ilyas9461/door-control-automation/foto/pcb3d.png

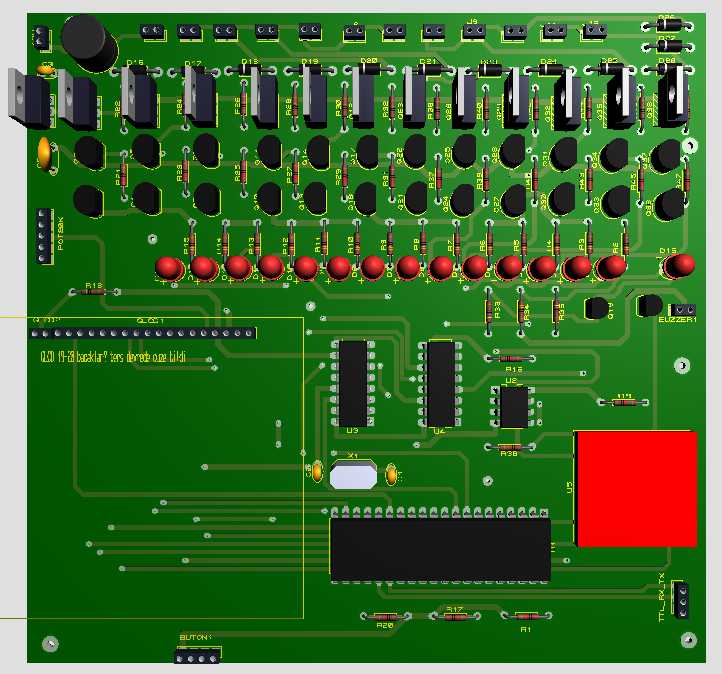
foto/pcb3d.png
