ilyas9461/door-control-automation/foto/Id-12 baglanti.JPG

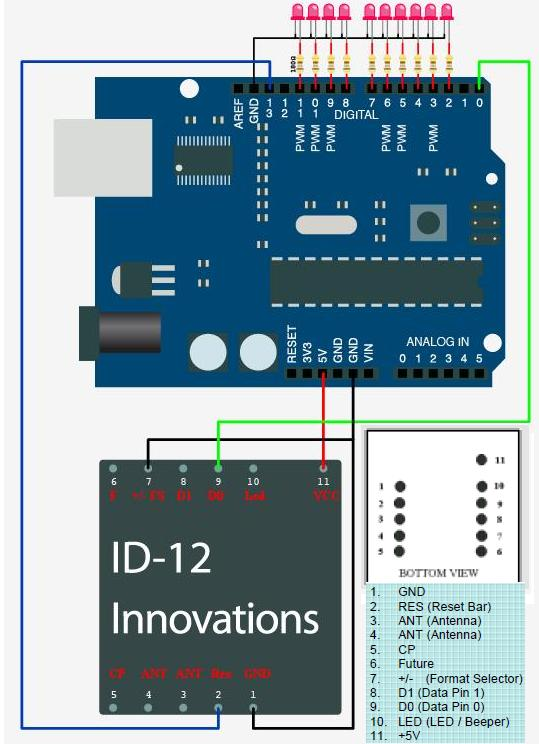
foto/Id-12 baglanti.JPG
