ilyas9461/door-control-automation/README.md

## **CONTACTLESS CARD DOOR CONTROL AUTOMATION PROJECT**

### Purpose of the Project :

Ensuring access control to work environments and preventing unnecessary entries by controlling the doors of work areas in any common area (corridor, etc.) from a central point with the contactless card (RFID Tag) given to each user.
Ensuring that entries and exits are made only with the permission of defined users.

[Click for sample working video...](https://youtu.be/mgzPTarc4ds)

### **The subject of the project** :

- RFID (Radio Frequency İdentification).
- MCU (PIC18F452)
- RFID.
- Door mechanical systems. 
- MOSFET drvers.
- Graphic LCD’s (GLCD).
- Microcontroller software languages and programming.
- PCB design.
