ilyas9461/door-control-automation/foto/calisma1.png

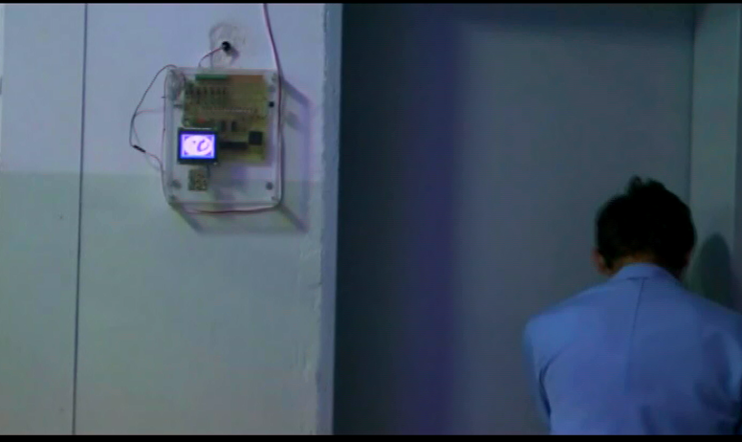
foto/calisma1.png
