ilyas9461/door-control-automation/foto/calisma2.png

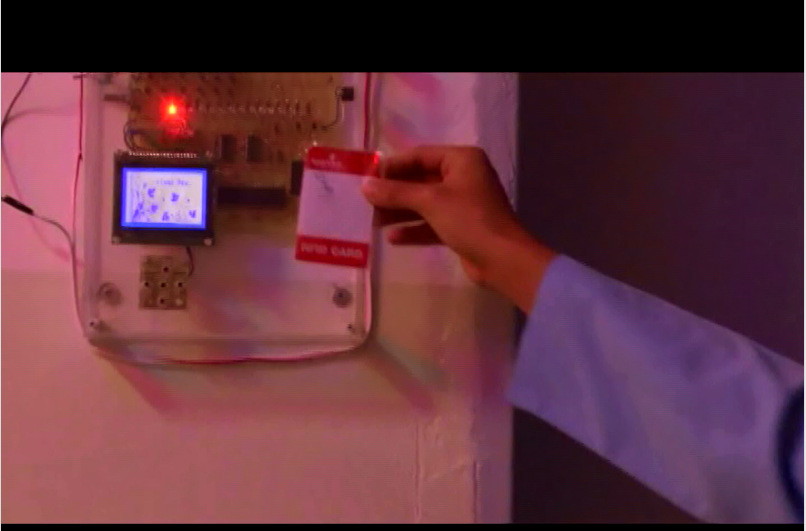
foto/calisma2.png
