ilyas9461/door-control-automation/foto/calisma3.png

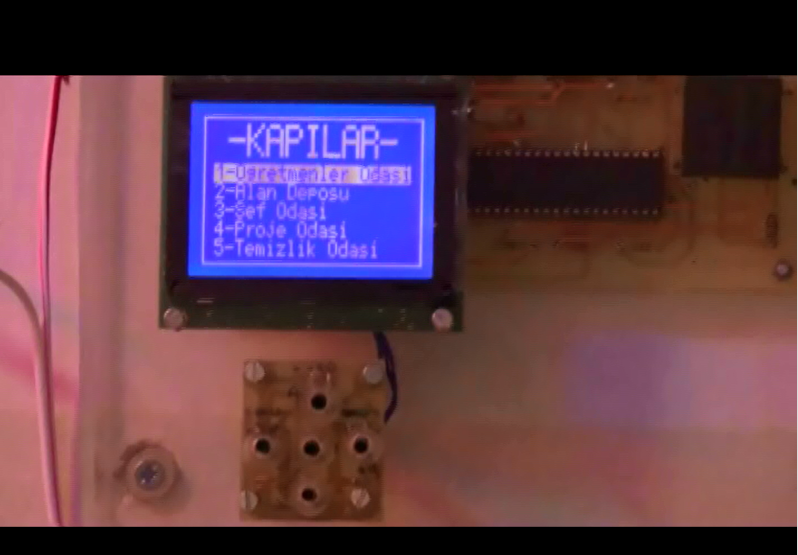
foto/calisma3.png
