ilyas9461/door-control-automation/foto/calisma4.png

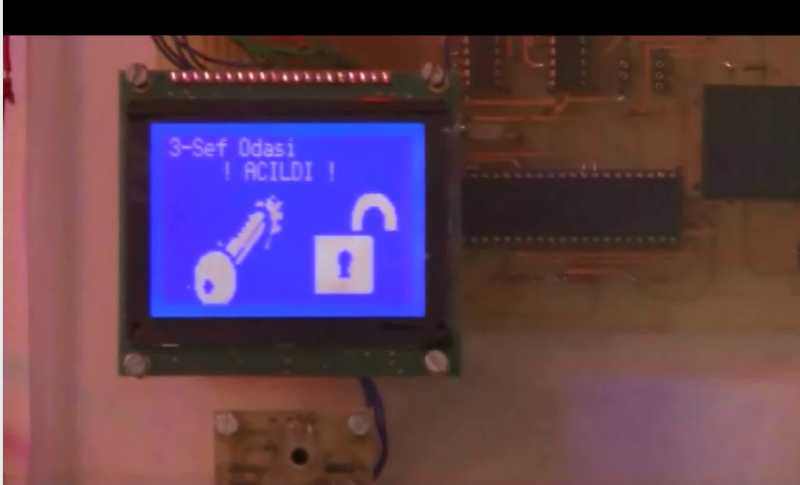
foto/calisma4.png
