ilyas9461/door-control-automation/foto/Rfid_GLCD_kapi_oto_pcb_irf640.PDF

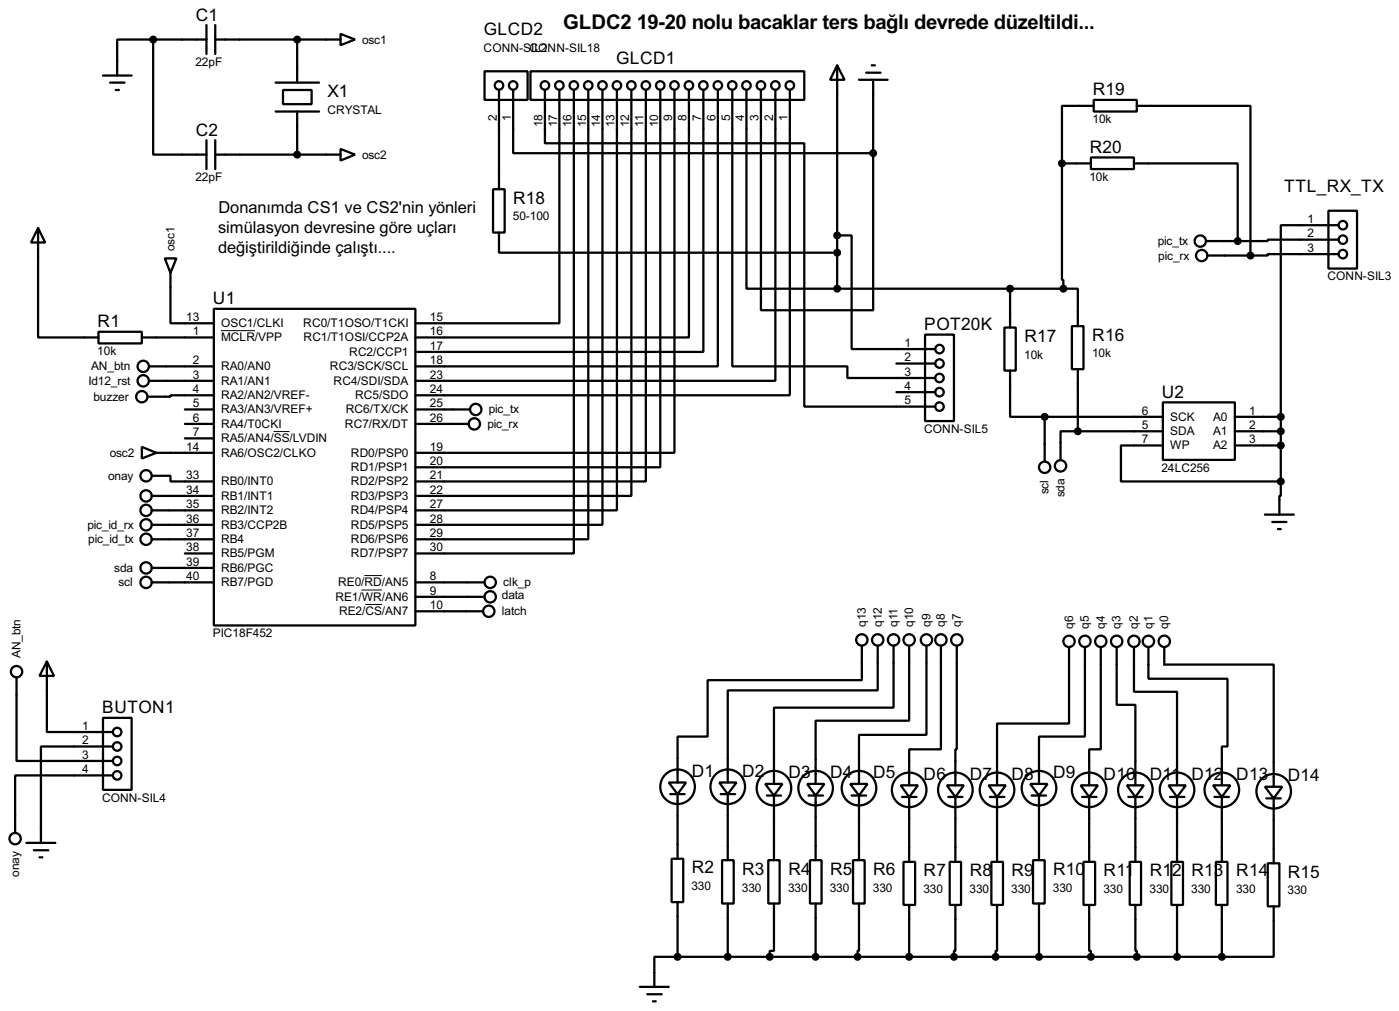
[picture p12: page 1]

GLDC2 19-20 nolu bacaklar ters bağlı devrede düzeltildi...

pic_rx pic_tx Donanımda CS1 ve CS2'nin yönleri
simülasyon devresine göre uçları değiştirildiğinde çalıştı....

24 RC6/TX/CK | | 4
25 RC7/RX/DT 26 | pic_tx pic_rx | 5

20 RD2/PSP2
21 RD3/PSP3
22 RD4/PSP4 27 RD5/PSP5

28 RD6/PSP6
29 RD7/PSP7

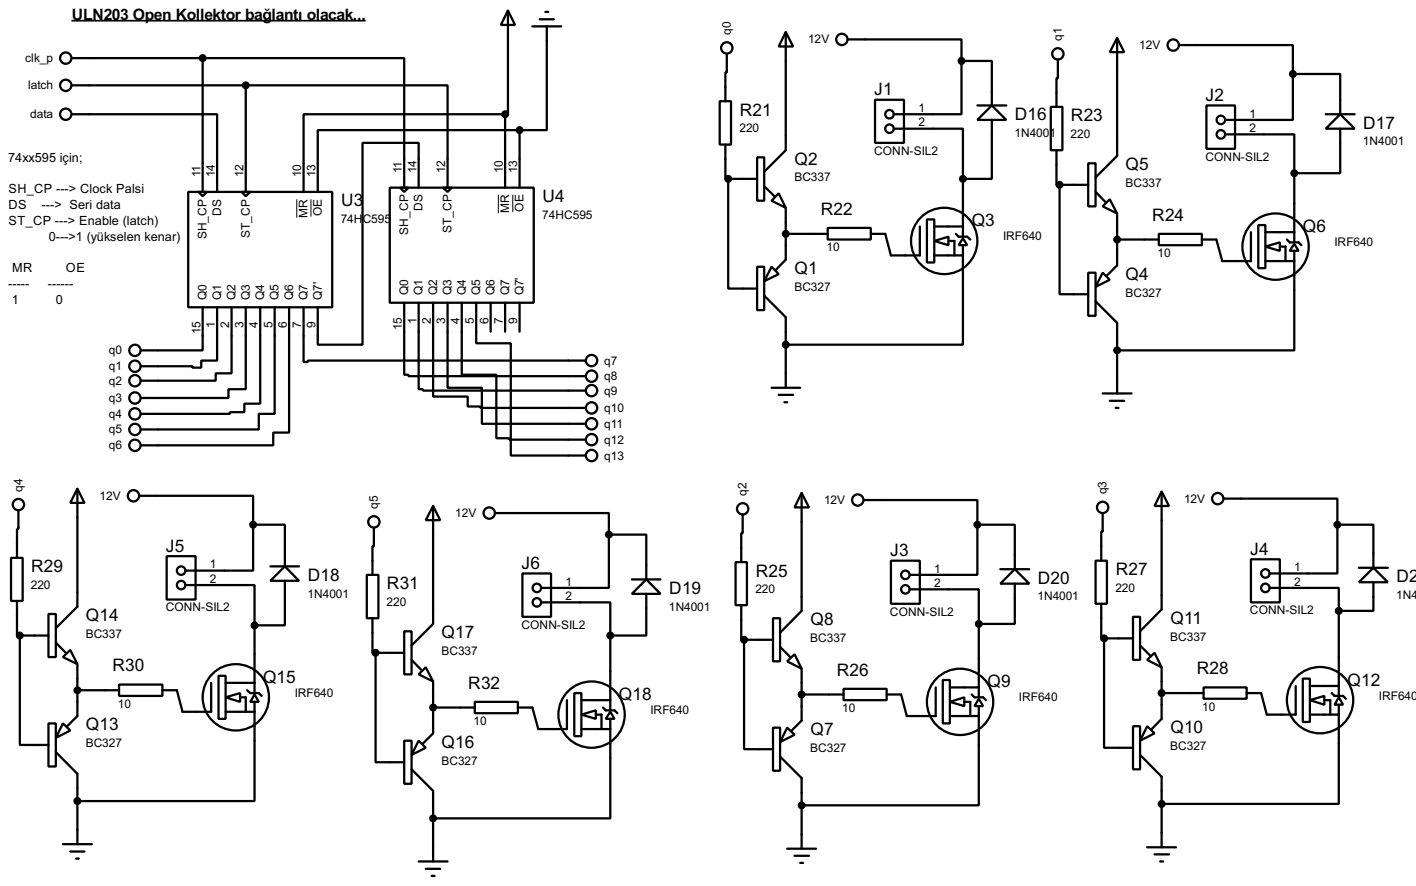
[picture p13: page 2]

ULN203 Open Kollektor bağlantı olacak...

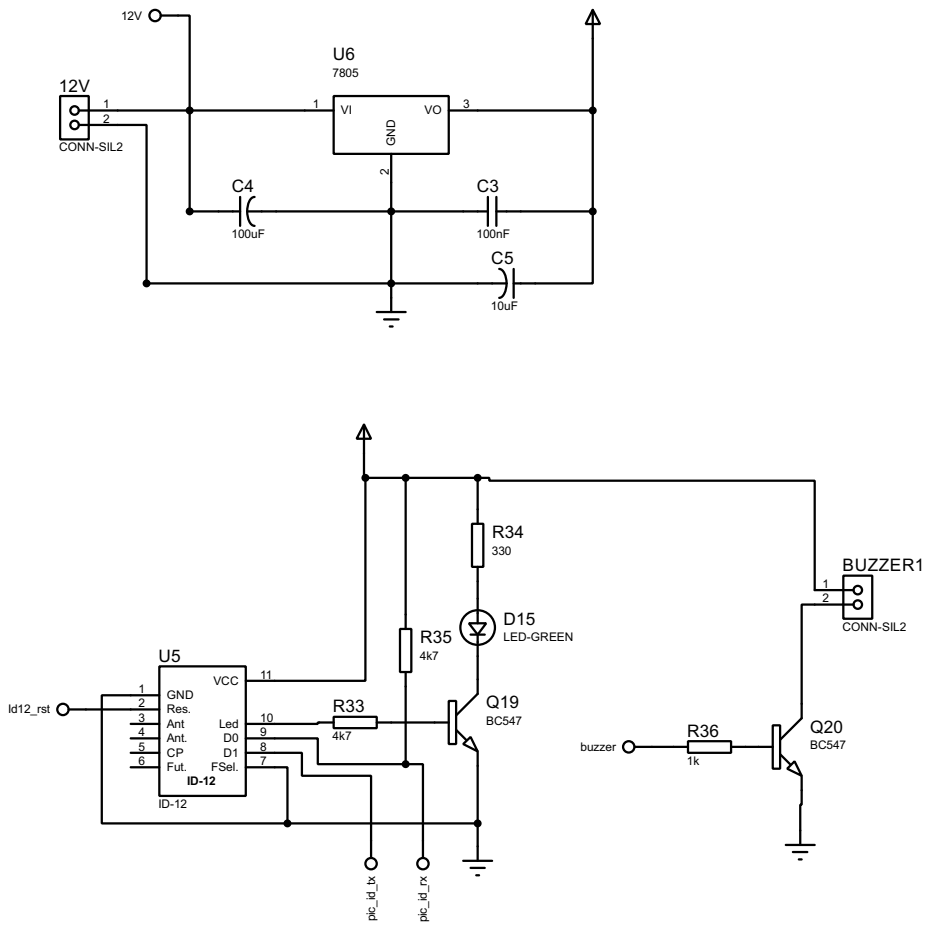
[picture p14: page 3]

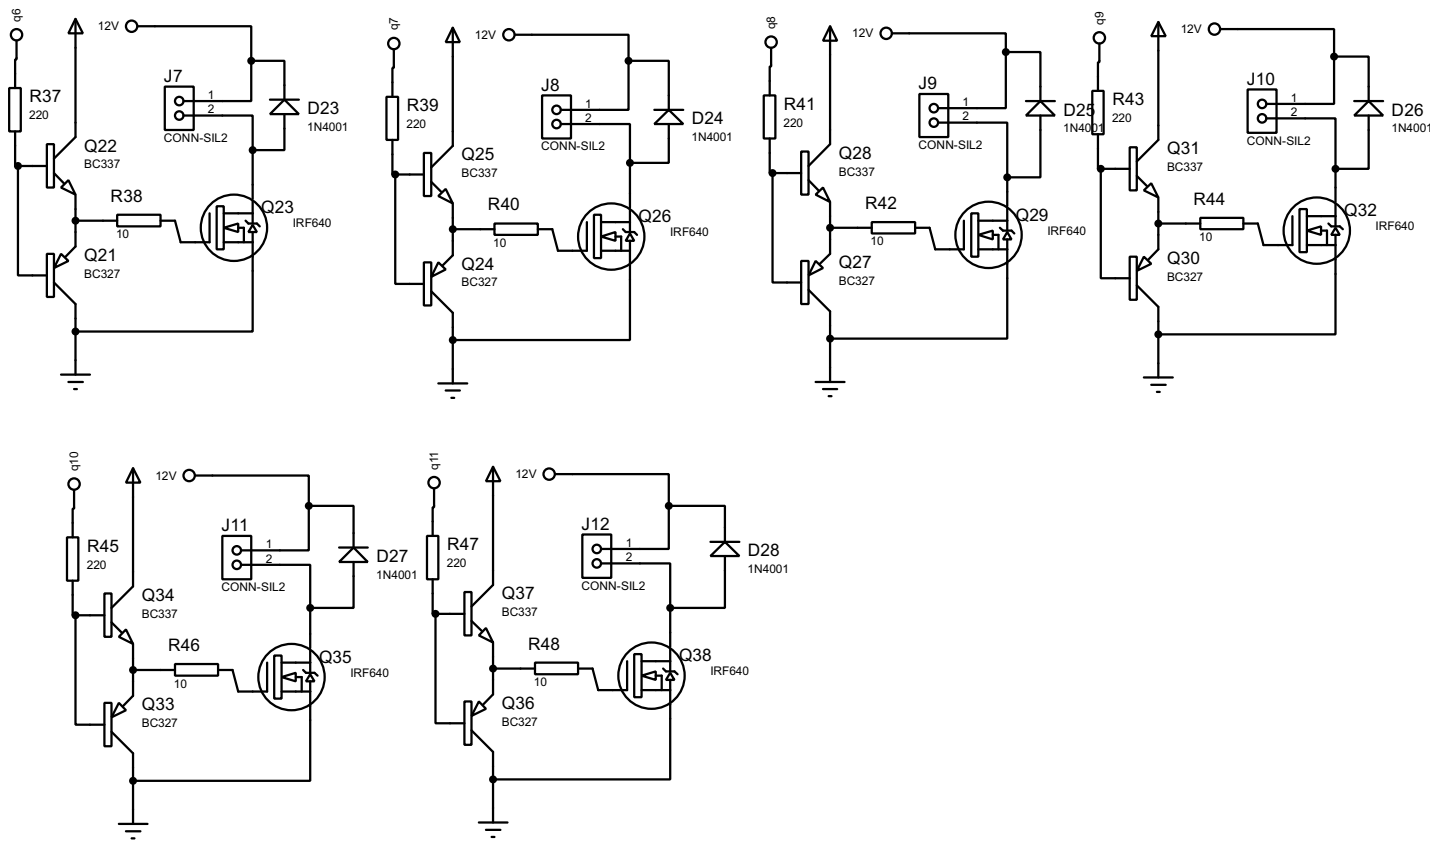
[picture p15: page 4]
