ilyas9461/door-control-automation/(list of files, drawings)

Other design files:
pcb/buton_pcb.DSN
pcb/buton_pcb.LYT
pcb/Rfid_GLCD_kapi_oto_pcb.DSN
pcb/Rfid_GLCD_kapi_oto_pcb.LYT
pcb/Rfid_GLCD_kapi_oto_pcb_irf640.DSN
pcb/Rfid_GLCD_kapi_oto_pcb_irf640.LYT
pcb/Rfid_GLCD_kapi_oto_pcb_irf640.pdsprj
src/Rfid_GLCD_kapi_oto.DSN
