ilyas9461/door-control-automation/src/logo_ttteml.c

const int logo_ttteml[]= { 
0xFF,0xFF,0xFF,0xFF,0xFF,0xFF,0x03,0x03,0x03,0x03,0x03,0x03,0x03,0x03,0x03,0x03,0x03,0x03,0x03,0x03,0x03,0x03,0x03,0x83,0xC3,0xC3,0xE3,0xE3,0xF3,0xF3,0xF3,0xF3,0xF3,0xFB,0xFB,0xFB,0xFB,0xFB,0xFF,0xFF,0xFD,0xFD,0xFC,0xFC,0xFE,0xFE,0xFE,0xFE,0xFF,0xFF,0xFF,0xFF,0xFF,0xFF,0xFF,0xFF,0xFF,0xFF,0xFF,0xFF,0xFF,0xFF,0xFF,0xFF,0xFF,0xFF,0xFF,0xFF,0xFF,0xFF,0xFF,0xFF,0xFF,0xFF,0xFF,0xFF,0xFF,0xFF,0xFF,0xFF,0xFF,0xFE,0xFE,0xFE,0xFC,0xFC,0xFC,0xFD,0xFD,0xFF,0xF3,0xFB,0xFB,0xFB,0xFB,0xFB,0xF3,0xF3,0xF3,0xF3,0xF3,0xE3,0xC3,0xC3,0x83,0x03,0x03,0x03,0x03,0x03,0x03,0x03,0x03,0x03,0x03,0x03,0x03,0x03,0x03,0x03,0x03,0x03,0x03,0xFF,0xFF,0xFF,0xFF,0xFF,
0xFF,0xFF,0xFF,0xFF,0xFF,0xFF,0x00,0x00,0x00,0x00,0x80,0xE0,0xE0,0xF0,0xF0,0xF8,0xFC,0xFC,0xFE,0xFE,0xFF,0xFF,0xFF,0xFF,0xFF,0xFF,0xFF,0xFF,0xFF,0xFF,0xFF,0xFF,0xFF,0xFF,0xFF,0xFF,0xFF,0xFF,0xFF,0xFF,0xFF,0xFF,0xFF,0xFF,0xFF,0xFF,0xFF,0xFF,0xFF,0xFF,0xFF,0xFF,0xFF,0xFF,0xFF,0xFF,0xFF,0xFF,0xFF,0xFF,0xFF,0xFF,0xFF,0xFF,0xFF,0xFF,0xFF,0xFF,0xFF,0xFF,0xFF,0xFF,0xFF,0xFF,0xFF,0xFF,0xFF,0xFF,0xFF,0xFF,0xFF,0xFF,0xFF,0x7F,0x1F,0x0F,0x01,0x01,0x01,0x07,0x07,0x0F,0x1F,0x1F,0xFF,0xFF,0xFF,0xFF,0xFF,0xFF,0xFF,0xFF,0xFF,0xFF,0xFF,0xFF,0xFF,0xFF,0xFE,0xFE,0xFC,0xFC,0xFC,0xF0,0xF0,0xE0,0xE0,0xC0,0x80,0x00,0x00,0x00,0x00,0xFF,0xFF,0xFF,0xFF,0xFF,
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
   long sayac=0;
   for(i=0;i<height;i+=8) {
      for(j=0;j<width;j++) {
         for(k=0;k<8;k++) 
         { 
           if(bit_test(logo_ttteml[sayac],k)){
             glcd_pixel(x+j,y+i+k,ON); 
           } //ifin               
         }
         sayac++;
      }//for j
   }//for i
}
